bkolko/foneastra/cad/Foneastra v2.3/PCB-4LEDs.jpg

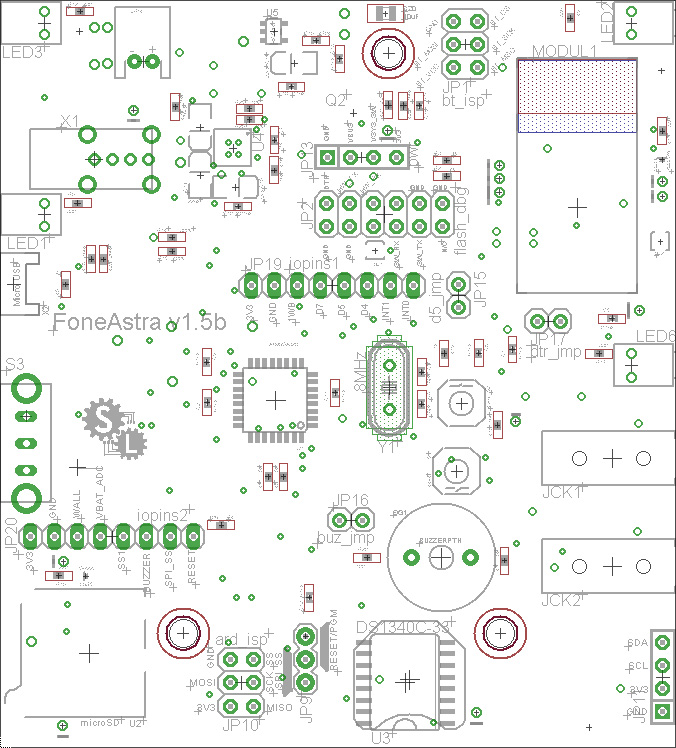
cad/Foneastra v2.3/PCB-4LEDs.jpg
