bkolko/foneastra/bom/FoneAstra Hardware BOM.xlsx

Sheet: Hardware Components
Item | Supplier | Supplier Part # | Manufacturer | Manufacturer Part # | Qty | Notes | Unit Cost | Extended Cost
18-8 Ss Flat Head Phillips Machine Screw, Black Oxide Finish, 6-32 Thread, 3/8" Length | McMaster | 96640A115 |  |  | 8 | Fasten Lid | $0.06 | $0.51
Thread-Forming 18-8SS Screw for Brittle Plastic | McMaster | 97349A210 |  |  | 2 | Set Screw | $0.07 | $0.13
Self-Lock Mushroom-Head Fastener, 1" Wide x 2" Long, Black Rectangle with Super Adhesive Back | McMaster | 87535K63 |  |  | 1 | Velcro | $1.64 | $1.64
Rubber pads | Amazon | 797734857047 |  | AHW071 | 4 | Pads for bottom of case | $0.07 | $0.30
18-8 Stainless Steel, 2-28 Thread, 1/4" Length | McMaster | 99461A715 |  |  | 3 | PCB Screw | $0.22 | $0.67
Weather-Resistant Foam Tape, 1" Width X 5 Yards Length, .063" Thick, Black | McMaster | 76545A92 |  |  | 2in | Adheisve Foam to hold battery | $1.81 | $1.81
Li-ion Battery 1500mAh or greater, 3.7V | SparkFun | PRT-08483 | Unionfortune | 585460 | 1 | Battery | $12.95 | $12.95
Temperature Sensor Probe | SparkFun | SEN-11050 | Dallas Semiconductor | DS18B20 | 1 |  | $9.95 | $9.95
Audio Plug 3.5mm | SparkFun | COM-11143 |  |  | 1 |  | $0.50 | $0.50
1' USB Cables | Amazon | B002L5ZEYY | StarTech | UUSBHAUB1 | 1 |  | $3.99 | $3.99
 |  |  |  |  |  |  |  | $32.45

Sheet: Assembly
Item | Manufacturer/Supplier | Notes | Cost/Unit
PCB | Advanced Circuits |  | $24.14
PCB Assembly | Reliance |  | $85.43
Hardware |  |  | $32.45
Enclosure | ProtoTech |  | $112.75
Labor |  | 60 minutes | $223.75
Total |  |  | $478.53
