bkolko/foneastra/bom/FoneAstra_v1_6_BOM.xlsx

Part | Value | Device | Package | Description | SparkFun | Manufacturer | Manufacturer # | Mouser | Digikey | INCLUDE | Qty | Note
BAT1 | 3V | BATTERY | BATTCON_12MM_CURVED | Battery Holders | http://www.sparkfun.com/products/10592 | MPD (Memory Protection Devices) | BK-885-TR | 534-3000 | BK-885TR-ND |  | 0
C1 | 0.1uF | CAP0402-CAP | 0402-CAP | Capacitor |  | TDK Corporation | C1005X7R1H104K050BB | 810-C1005X7R1H104K | 445-13671-1-ND | x | 1
C10 | 10nF | CAP0402-CAP | 0402-CAP | Capacitor |  | Vishay BC Components | VJ0402Y103KXJCW1BC | 77-VJ0402Y103KXJCBC | BC1217TR-ND | x | 1
C11 | 0.1uF | CAP0402-CAP | 0402-CAP | Capacitor |  | TDK Corporation | C1005X7R1H104K050BB | 810-C1005X7R1H104K | 445-13671-1-ND | x | 1
C12 | 0.1uF | CAP0402-CAP | 0402-CAP | Capacitor |  | TDK Corporation | C1005X7R1H104K050BB | 810-C1005X7R1H104K | 445-13671-1-ND | x | 1
C13 | 0.1uF | CAP0402-CAP | 0402-CAP | Capacitor |  | TDK Corporation | C1005X7R1H104K050BB | 810-C1005X7R1H104K | 445-13671-1-ND | x | 1
C14 | 22uF | CAP_POL1206 | EIA3216 | Capacitor Polarized |  | TDK Corporation | C3216X5R0J226M | 810-C3216X5R0J226M | 445-7717-1-ND | x | 1 | note the part is not really polarized, just the EAGLE footprint
C15 | 22uF | CAP_POL1206 | EIA3216 | Capacitor Polarized |  | TDK Corporation | C3216X5R0J226M | 810-C3216X5R0J226M | 445-7717-1-ND | x | 1 | note the part is not really polarized, just the EAGLE footprint
C16 | 470p | CAP0402-CAP | 0402-CAP | Capacitor |  | Samsung Electro-Mechanics America, Inc | CL05B471KB5NNNC | 581-04025C471K | 1276-1566-1-ND | x | 1
C17 | 22uF | CAP_POL1206 | EIA3216 | Capacitor Polarized |  | TDK Corporation | C3216X5R0J226M | 810-C3216X5R0J226M | 445-7717-1-ND | x | 1
C18 | 0.1uF | CAP0402-CAP | 0402-CAP | Capacitor |  | TDK Corporation | C1005X7R1H104K050BB | 810-C1005X7R1H104K | 445-13671-1-ND | x | 1
C19 | 0.1uF | CAP0402-CAP | 0402-CAP | Capacitor |  | TDK Corporation | C1005X7R1H104K050BB | 810-C1005X7R1H104K | 445-13671-1-ND | x | 1 | model tbd
C20 | 10uf | CAP0805-CAP | 0805-CAP | Capacitor |  | TDK Corporation | C2012X7R0J106K125AB |  | 445-7593-1-ND | x | 1 | extra cap on 3V3. With BT soft start, may not be necessary. Chose 0805 because it's cheaper than 0402.
C21 | 1uF | CAP0402-CAP | 0402-CAP | Capacitor |  | TDK Corporation | C1005X5R1A105K050BB |  | 445-4114-1-ND | x
C2 | 0.1uF | CAP0402-CAP | 0402-CAP | Capacitor |  | TDK Corporation | C1005X7R1H104K050BB | 810-C1005X7R1H104K | 445-13671-1-ND | x | 1
C3 | 18pF | CAP0402-CAP | 0402-CAP | Capacitor |  | TDK Corporation | C1005C0G1H180J050BA | 810-C1005C0G1H180J | 445-1238-1-ND | x | 1
C4 | 18pF | CAP0402-CAP | 0402-CAP | Capacitor |  | TDK Corporation | C1005C0G1H180J050BA | 810-C1005C0G1H180J | 445-1238-1-ND | x | 1
C5 | 0.1uF | CAP0402-CAP | 0402-CAP | Capacitor |  | TDK Corporation | C1005X7R1H104K050BB | 810-C1005X7R1H104K | 445-13671-1-ND | x | 1
C6 | 10uF | CAP_POL1206 | EIA3216 | Capacitor Polarized |  | TDK Corporation | C3216X5R1C106M160AA | 810-C3216X5R1C106M | 445-1426-1-ND | x | 1 | note the part is not really polarized, just the EAGLE footprint
C7 | 10n | CAP0402-CAP | 0402-CAP | Capacitor |  | Vishay BC Components | VJ0402Y103KXJCW1BC | 77-VJ0402Y103KXJCBC | BC1217TR-ND | x | 1
C8 | 0.1uF | CAP0402-CAP | 0402-CAP | Capacitor |  | TDK Corporation | C1005X7R1H104K050BB | 810-C1005X7R1H104K | 445-13671-1-ND | x | 1
C9 | 0.1uF | CAP0402-CAP | 0402-CAP | Capacitor |  | TDK Corporation | C1005X7R1H104K050BB | 810-C1005X7R1H104K | 445-13671-1-ND | x | 1
JCK1 | 35RASMT4BHNTRX | 35RASMT4BHNTRX | 35RASMT4BHNTRX |  |  | Switchcraft Inc. | SC1488-1-ND | 502-35RASMT4BHNTRX | SC1488-1-ND |  | 0
JCK2 | 35RASMT4BHNTRX | 35RASMT4BHNTRX | 35RASMT4BHNTRX |  |  | Switchcraft Inc. | SC1488-1-ND | 502-35RASMT4BHNTRX | SC1488-1-ND | x | 1 | not fitting this part now
JCK3 | 35RASMT4BHNTRX | 35RASMT4BHNTRX | 35RASMT4BHNTRX |  |  | Switchcraft Inc. | SC1488-1-ND | 502-35RASMT4BHNTRX | SC1488-1-ND |  | 0 | not fitting this part not
JP1 | bt_isp | PINHD-2X3 | 2X03 | PIN HEADER | https://www.sparkfun.com/products/12807 | FCI | 67996-206HLF |  | 609-3210-ND | x | 1 | do we meed to install this header in production boards?
JP10 | ard_isp | PINHD-2X3 | 2X03 | PIN HEADER | https://www.sparkfun.com/products/12807 | FCI | 67996-206HLF |  | 609-3210-ND | x | 1 | Can be made from strip(s) of 0.1 breakaway
JP11 | I2C | PINHD-1X4 | 1X04 | PIN HEADER |  | 3M | 961104-6404-AR | 517-9611046404AR |  |  | 0 | Can be made from strip(s) of 0.1 breakaway
JP19 | iopins1 | PINHD-1X8 | 1X08 | PIN HEADER |  | Harwin Inc | M20-9990846 | 649-68418-413HLF | 952-2271-ND |  | 0 | Can be made from strip(s) of 0.1 breakaway
JP20 | iopins2 | PINHD-1X8 | 1X08 | PIN HEADER |  | Harwin Inc | M20-9990846 | 855-M20-9990846 | 952-2271-ND |  | 0 | Can be made from strip(s) of 0.1 breakaway
JP13 | pwr | PINHD-1X4 | 1X04 | PIN HEADER |  | 3M | 961104-6404-AR | 517-9611046404AR |  |  | 0 | Can be made from strip(s) of 0.1 breakaway
JP14 | battconn | M02JST-PTH | JST-2-PTH | 2 pin JST header | https://www.sparkfun.com/products/9749 | JST Sales America Inc | S2B-PH-K-S(LF)(SN) |  | 455-1719-ND | x | 1 | need to doublecheck digikey is same as SF
JP15 | d5_jmp | PINHD-1X2 | 1X02 | PIN HEADER |  | 3M | 961102-6404-AR | 517-9611026404AR |  |  | 0 | Can be made from strip(s) of 0.1 breakaway
JP16 | buz_jmp | PINHD-1X2 | 1X02 | PIN HEADER |  | 3M | 961102-6404-AR | 517-9611026404AR |  |  | 0 | Can be made from strip(s) of 0.1 breakaway
JP17 | dtr_jmp | PINHD-1X2 | 1X02 | PIN HEADER |  | 3M | 961102-6404-AR | 517-9611026404AR |  |  | 0 | Can be made from strip(s) of 0.1 breakaway
JP2 | flash_dbg | PINHD-2X6 | 2X06 | PIN HEADER |  |  |  |  |  |  | 0 | Can be made from strip(s) of 0.1 breakaway
JP3 | SPARKFUN_FIDUCIAL1.5X3 | SPARKFUN_FIDUCIAL1.5X3 | SPARKFUN_FIDUCIAL-1.5X3 | Fiducial Alignment Points |  |  |  |  |  |  | 0 | not a part
JP4 | STAND-OFFTIGHT | STAND-OFFTIGHT | STAND-OFF-TIGHT | #4 Stand Off |  |  |  |  |  |  | 0 | not a part
JP5 | SPARKFUN_FIDUCIAL1.5X3 | SPARKFUN_FIDUCIAL1.5X3 | SPARKFUN_FIDUCIAL-1.5X3 | Fiducial Alignment Points |  |  |  |  |  |  | 0 | not a part | may want to consider enlarging this to 2x8 to find more parts
JP6 | STAND-OFFTIGHT | STAND-OFFTIGHT | STAND-OFF-TIGHT | #4 Stand Off |  |  |  |  |  |  | 0 | not a part
JP7 | SPARKFUN_FIDUCIAL1.5X3 | SPARKFUN_FIDUCIAL1.5X3 | SPARKFUN_FIDUCIAL-1.5X3 | Fiducial Alignment Points |  |  |  |  |  |  | 0 | not a part
JP8 | STAND-OFFTIGHT | STAND-OFFTIGHT | STAND-OFF-TIGHT | #4 Stand Off |  |  |  |  |  |  | 0 | not a part
JP9 | spi_jmp | M03PTH | 1X03 | Header 3 |  | 3M | 961103-6804-AR | 517-9611036804AR | 961103-6804-AR-ND | x | 1 | Can be made from strip(s) of 0.1 breakaway
LED1 | RED | LED | LXH4 | LEDs |  | Lumex Opto/Components Inc | SSF-LXH4RAID |  | 67-1303-ND | x | 1
LED2 | YELLOW | LED | LXH4 | LEDs |  | Lumex Opto/Components Inc | SSF-LXH4RAYD |  | 67-1305-ND | x | 1 | Note: LXH series has no blue. This is green. There is only red, green, yellow in this exact body
LED3 | RED | LED | LXH4 | LEDs |  | Lumex Opto/Components Inc | SSF-LXH4RAID |  | 67-1303-ND | x | 1
LED4 | YELLOW | LED0603 | LED-0603 | LEDs |  | Vishay Semiconductor Opto Division | TLMY1100-GS08 | 720-LYQ976-P1S2-36 | 751-1186-1-ND | x | 1
LED5 | Green | LED0603 | LED-0603 | LEDs |  | Stanley Electric Co | PG1111C-TR | 720-LGQ971-KN-1 | 404-1004-1-ND | x | 1
LED6 | RED | LED | LXH4 | LEDs |  | Lumex Opto/Components Inc | SSF-LXH4RAID |  | 67-1303-ND | x | 1 | Note: LXH series has no blue. This is green. There is only red, green, yellow in this exact body
Y1 | 8MHz | CRYSTALHC49S | HC49/S | CRYSTAL |  | CTS-Frequency Controls | ATS080B | 695-HC49US-8-U | CTX900-ND | x | 1
Q2 | FDN306P | FDN306P | MYSOT23 |  |  | Fairchild Semiconductor | FDN306P | 512-FDN306P | FDN306PCT-ND | x | 1
R1 | 5k | RESISTOR0402-RES | 0402-RES | Resistor |  | Panasonic Electronic Components | ERJ-2GEJ512X |  | P5.1KJCT-ND | x | 1 | note: none of these resistor tolerances are very important, go with cheapest
R10 | 10k | RESISTOR0402-RES | 0402-RES | Resistor |  | Vishay Dale | CRCW040210K0FKED | 71-CRCW0402-10K-E3 | 541-10.0KLCT-ND | x | 1
R11 | 330 | RESISTOR0402-RES | 0402-RES | Resistor |  | Panasonic Electronic Components | ERJ-2GEJ331X | ERJ-2GEJ331X | P330JCT-ND | x | 1
R12 | 100 | RESISTOR0402-RES | 0402-RES | Resistor |  | Panasonic Electronic Components | ERJ-2GEJ101X | ERJ-2GEJ101X | P100JCT-ND | x | 1
R13 | 10K | RESISTOR0402-RES | 0402-RES | Resistor |  | Vishay Dale | CRCW040210K0FKED |  | 541-10.0KLCT-ND | x | 1
R14 | 300k | RESISTOR0402-RES | 0402-RES | Resistor |  | Panasonic Electronic Components | ERJ-2GEJ304X |  | P300KJCT-ND | x | 1
R15 | 100k | RESISTOR0402-RES | 0402-RES | Resistor |  | Vishay Dale | CRCW0402100KFKED |  | 541-10.0KLCT-ND | x | 1
R16 | 220 | RESISTOR0402-RES | 0402-RES | Resistor |  | Panasonic Electronic Components | ERJ-2RKF2200X |  | P220LCT-ND | x | 1
R17 | 100 | RESISTOR0402-RES | 0402-RES | Resistor |  | Panasonic Electronic Components | ERJ-2GEJ101X | ERJ-2GEJ101X | P100JCT-ND | x | 1
R18 | 100k | RESISTOR0402-RES | 0402-RES | Resistor |  | Vishay Dale | CRCW0402100KFKED |  | 541-10.0KLCT-ND | x | 1
R19 | 1k | RESISTOR0402-RES | 0402-RES | Resistor |  | Panasonic Electronic Components | ERJ-2GEJ102X |  | 541-10.0KLCT-ND | x | 1
R2 | 1k | RESISTOR0402-RES | 0402-RES | Resistor |  | Panasonic Electronic Components | ERJ-2GEJ102X |  | P1.0KJCT-ND | x | 1
R20 | 100 | RESISTOR0402-RES | 0402-RES | Resistor |  | Panasonic Electronic Components | ERJ-2GEJ101X |  | P100JCT-ND | x | 1
R21 | 100k | RESISTOR0402-RES | 0402-RES | Resistor |  | Vishay Dale | CRCW0402100KFKED |  | 541-10.0KLCT-ND | x | 1
R22 | 2.2M | RESISTOR0402-RES | 0402-RES | Resistor |  | Vishay Dale | CRCW04022M20JNED |  | 541-2.2MJCT-ND | x | 1
R23 | 200k | RESISTOR0402-RES | 0402-RES | Resistor |  | Vishay Dale | CRCW0402200KJNED |  | 541-200KJCT-ND | x | 1
R24 | 10k | RESISTOR0402-RES | 0402-RES | Resistor |  | Vishay Dale | CRCW040210K0FKED |  | 541-10.0KLCT-ND | x | 1
R25 | 10k | RESISTOR0402-RES | 0402-RES | Resistor |  | Vishay Dale | CRCW040210K0FKED |  | 541-10.0KLCT-ND | x | 1
R26 | 10k | RESISTOR0402-RES | 0402-RES | Resistor |  | Vishay Dale | CRCW040210K0FKED |  | 541-10.0KLCT-ND | x | 1
R3 | 1k | RESISTOR0402-RES | 0402-RES | Resistor |  | Panasonic Electronic Components | ERJ-2GEJ102X |  | 541-10.0KLCT-ND | x | 1
R4 | 10K | RESISTOR0402-RES | 0402-RES | Resistor |  | Panasonic Electronic Components | ERJ-2GEJ103X |  | P10KJCT-ND | x | 1
R5 | 0 | RESISTOR0402-RES | 0402-RES | Resistor |  | Vishay Dale | CRCW04020000Z0ED | 71-CRCW0402-0-E3 | 541-0.0JCT-ND |  | 0 | do not fit unless we decide we need it later to incrase charge current
R6 | 100 | RESISTOR0402-RES | 0402-RES | Resistor |  | Panasonic Electronic Components | ERJ-2GEJ101X |  | P100JCT-ND | x | 1
R7 | 5k | RESISTOR0402-RES | 0402-RES | Resistor |  | Vishay Dale | CRCW04024K70JNED | 71-CRCW0402J-4.7K-E3 | 541-4.7KJCT-ND | x | 1
R8 | 5k | RESISTOR0402-RES | 0402-RES | Resistor |  | Vishay Dale | CRCW04024K70JNED | 71-CRCW0402J-4.7K-E3 | 541-4.7KJCT-ND | x | 1 | note: I swapped out these 5k resistors for 4.7k resistors. Should not make a difference, and these are more common and cheaper
R9 | 100 | RESISTOR0402-RES | 0402-RES | Resistor |  | Panasonic Electronic Components | ERJ-2GEJ101X | ERJ-2GEJ101X | P100JCT-ND | x | 1
S1 | Reset | TAC_SWITCHSMD | TACTILE_SWITCH_SMD | Momentary Switch |  | C&K Components | PTS525SM10SMTR LFS | 611-PTS525SM10-LFS | CKN9104CT-ND | x | 1 | note: orig digikey part number EG1831-ND seems wrong for this switch; I updated it to what I think matches the footprint
S3 | E-SWITCH-EG1206 | E-SWITCH-EG1206 | EG1206 |  |  | E-Switch | EG1206 | 612-EG1206 | EG1916-ND | x | 1
S2 | intsw | SPARKFUN_TAC_SWITCHSMD | SPARKFUN_TACTILE_SWITCH_SMD | Momentary Switch |  | C&K Components | PTS525SM10SMTR LFS | 611-PTS525SM10-LFS | CKN9104CT-ND | x | 1 | note: orig digikey part number EG1831-ND seems wrong for this switch; I updated it to what I think matches the footprint
SG1 | BUZZERPTH | BUZZERPTH | BUZZER-12MM | Buzzer 12mm | https://www.sparkfun.com/products/7950 | CUI Inc | CEM-1203(42) | 254-EMB140-RO | 102-1153-ND |  | 0
SJ1 |  | SOLDERJUMPERNC2 | SJ_2S-NOTRACE | Solder Jumper |  |  |  |  |  |  | 0 | not a part
SJ2 |  | SOLDERJUMPERNC2 | SJ_2S-NOTRACE | Solder Jumper |  |  |  |  |  |  | 0 | not a part
TP3 | SS | TESTPOINT | TESTPOINT |  |  |  |  |  |  |  | 0 | not a part
TP1 | BT_RESET | TESTPOINT | TESTPOINT |  |  |  |  |  |  |  | 0 | not a part
TP10 | PIO4 | TESTPOINT | TESTPOINT |  |  |  |  |  |  |  | 0 | not a part
TP11 | BT_PWR | TESTPOINT | TESTPOINT |  |  |  |  |  |  |  | 0 | not a part
TP12 | BT_VCC | TESTPOINT | TESTPOINT |  |  |  |  |  |  |  | 0 | not a part
TP2 | FT/OUT | TESTPOINT | TESTPOINT |  |  |  |  |  |  |  | 0 | not a part
TP4 | PIO3 | TESTPOINT | TESTPOINT |  |  |  |  |  |  |  | 0 | not a part
TP5 | PIO7 | TESTPOINT | TESTPOINT |  |  |  |  |  |  |  | 0 | not a part
TP6 | PIO6 | TESTPOINT | TESTPOINT |  |  |  |  |  |  |  | 0 | not a part
TP7 | PIO5 | TESTPOINT | TESTPOINT |  |  |  |  |  |  |  | 0 | not a part
TP8 | GND | TESTPOINT | TESTPOINT |  |  |  |  |  |  |  | 0 | not a part
TP9 | GND | TESTPOINT | TESTPOINT |  |  |  |  |  |  |  | 0 | not a part
U1 | ATMEGA328 | ATMEGA168 | TQFP32-08 |  |  | Atmel | ATMEGA328P-AU | 556-ATMEGA328P-AU | ATMEGA328P-AU-ND | x | 1
U2 | microSD | USD-SOCKETSMD | MICRO-SD-SOCKET-PP | microSD Socket | SFE: https://www.sparkfun.com/products/127 | 3M | 2908-05WB-MG |  | 3M5607CT-ND | x | 1 | need to double check -- SFE part does not give manufacturer number. 3M part seems to be the right one, but..
MODUL1 | BLUETOOTH-RN42 | BLUETOOTH-RN41","RN41 |  |  | SFE: https://www.sparkfun.com/products/10253 | Microchip Technology | RN42-I/RM |  | 740-1038-ND | x | 1 | need to double check -- there are several RN-42s, slightly different
U3 | DS1340C-33 | DS1340C-33 | SO16L |  |  | Maxim Integrated | DS1340C-33#T&R |  | DS1340C-33#-ND |  | 0
U4 | ADP5062 | ADP5062 | LFCSP_WQ20 |  |  | Analog Devices Inc | ADP5062ACPZ-2-R7 | 584-ADP5062ACPZ-1-R7 | ADP5062ACPZ-2-R7CT-ND | x | 1
U5 | MIC5245 | V_REG_LDOSMD | SOT23-5 | Voltage Regulator LDO |  | Micrel Inc | MIC5245-3.3YM5 |  | 576-2790-1-ND | x | 1
X1 | MOLEX48204_USB_A_VERT | MOLEX48204_USB_A_VERT |  | USB Connectors | 538-48204-0001 | Molex Inc | 482040001 | WM17532-ND | WM17532-ND | x | 1
X2 | Micro USB | USB-MICROB | USB-MICROB | USB Connectors |  | FCI | 10104111-0001LF |  | 609-4053-1-ND | x | 1
