bkolko/foneastra/cad/Foneastra v2.3/phonejack-35RASMT.SLDPRT

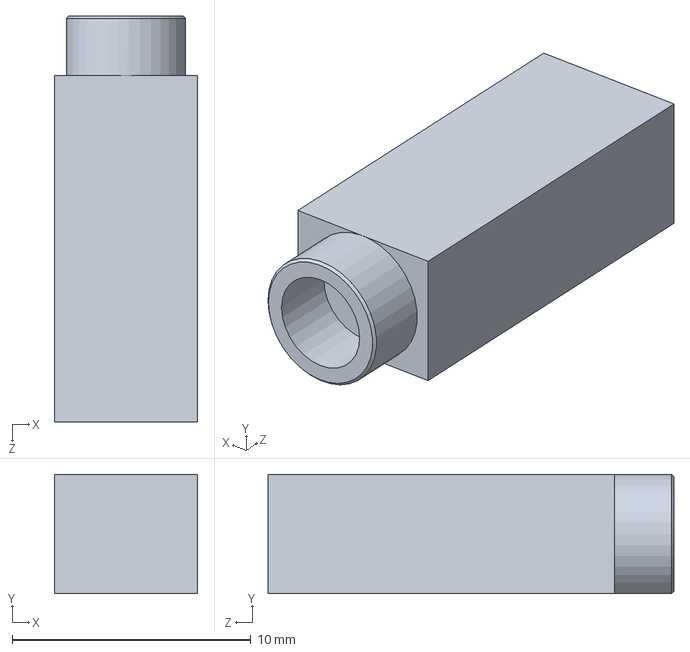
[picture p4: CAD file, 2015-06-15]
cad/Foneastra v2.3/phonejack-35RASMT.SLDPRT
6.00 x 5.00 x 17.0 mm
