bkolko/foneastra/cad/Foneastra v2.3/FoneAstra_PCB1-5.SLDASM

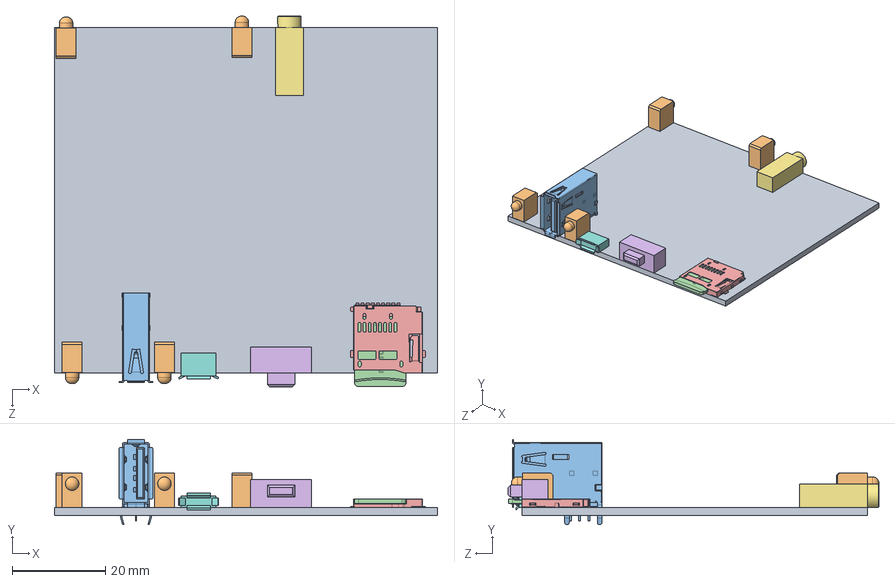
[picture p5: CAD file, 2015-06-15]
cad/Foneastra v2.3/FoneAstra_PCB1-5.SLDASM
82.0 x 18.3 x 79.4 mm
PCB
LED_3mm_591-2601-013F x 4
sd
slot
Switch-EG1916
phonejack-35RASMT
microUSB-10104
