bkolko/foneastra/cad/Foneastra v2.3/Foneastra_v2-3_Assembled.SLDASM

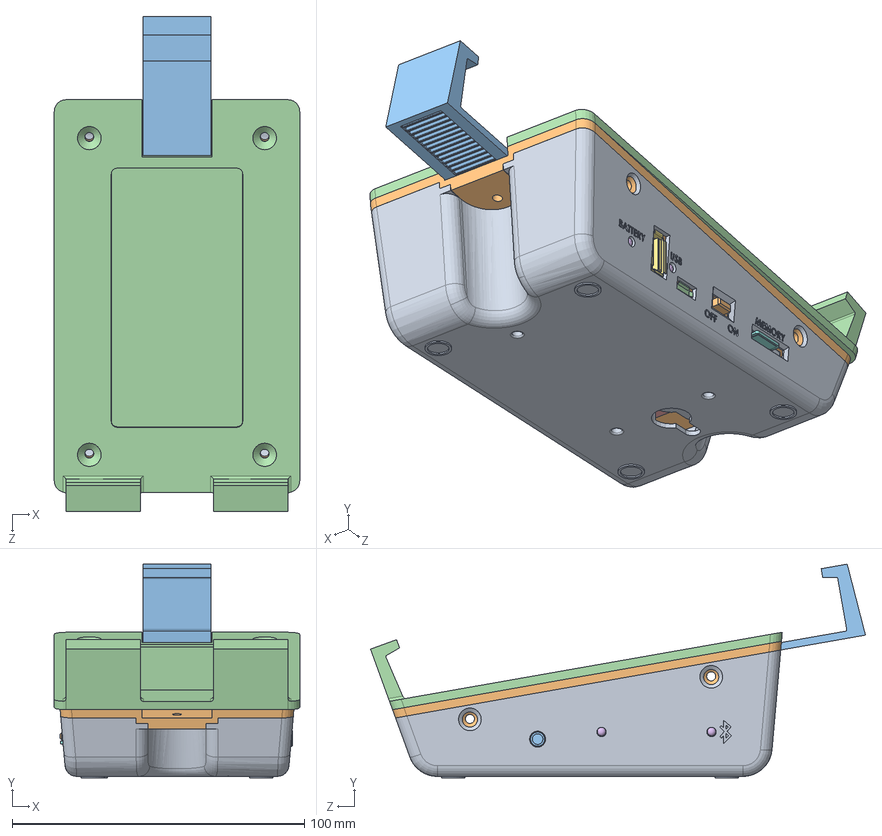
[picture p6: CAD file, 2015-06-15]
cad/Foneastra v2.3/Foneastra_v2-3_Assembled.SLDASM
84.0 x 73.1 x 169.3 mm
Lid
Slider
Sled
PCB
LED_3mm_591-2601-013F x 4
sd
slot
Switch-EG1916
phonejack-35RASMT
microUSB-10104
