bkolko/foneastra/cad/Foneastra v2.3/SD-card.SLDASM

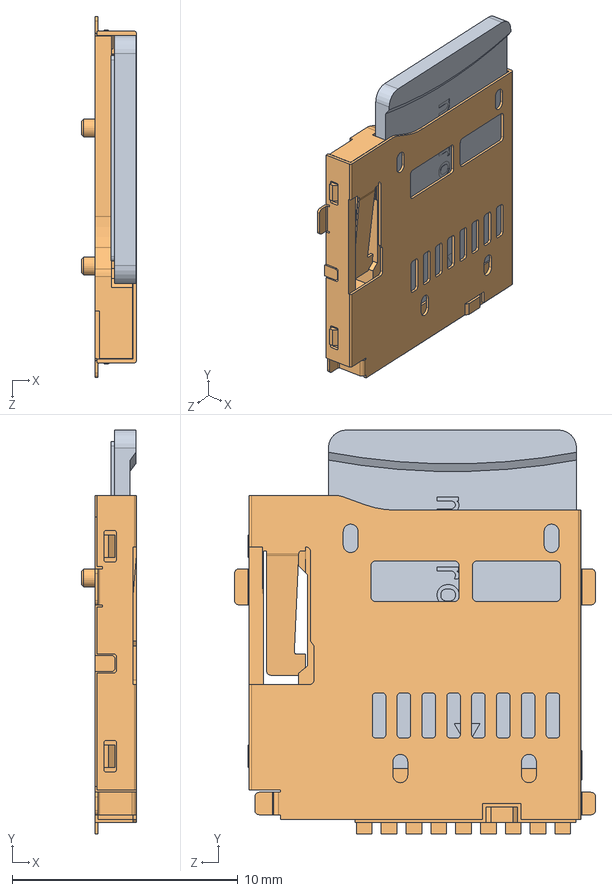
[picture p7: CAD file, 2015-06-15]
cad/Foneastra v2.3/SD-card.SLDASM
2.44 x 17.9 x 16.0 mm
sd
slot
