bkolko/foneastra/cad/Foneastra v2.3/LED_3mm_591-2601-013F.sldprt

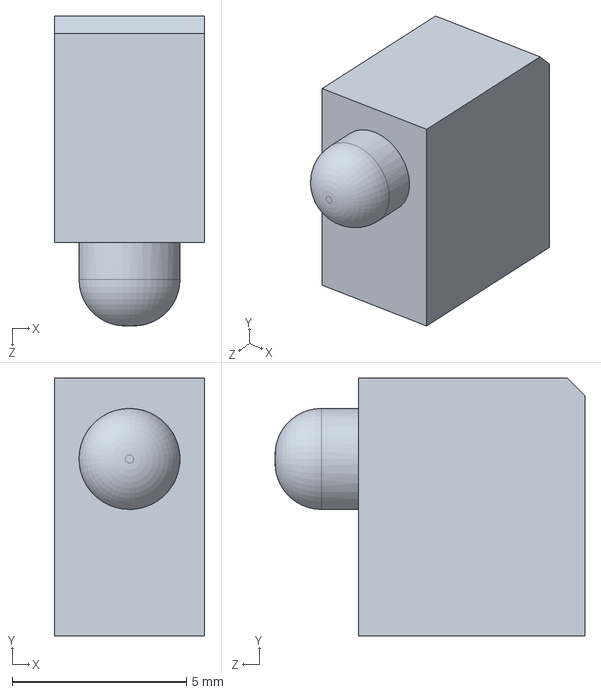
[picture p8: CAD file, 2015-06-15]
cad/Foneastra v2.3/LED_3mm_591-2601-013F.sldprt
4.32 x 7.40 x 8.90 mm
