bkolko/foneastra/cad/Foneastra v2.3/Sled.sldprt

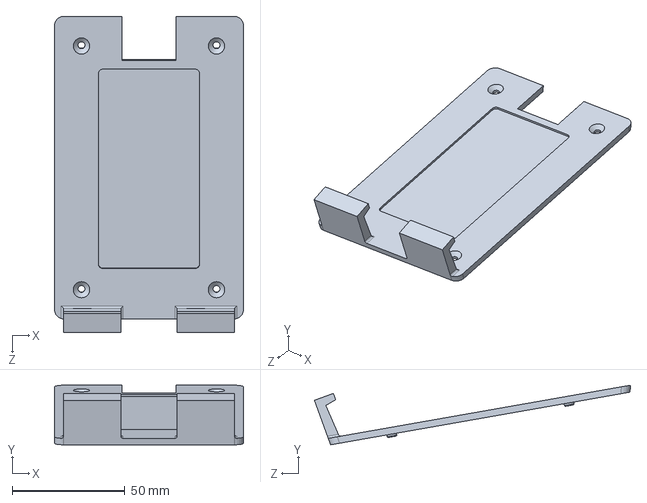
[picture p9: CAD file, 2015-06-15]
cad/Foneastra v2.3/Sled.sldprt
84.0 x 26.5 x 140.5 mm
