bkolko/foneastra/cad/Foneastra v2.3/Slider.sldprt

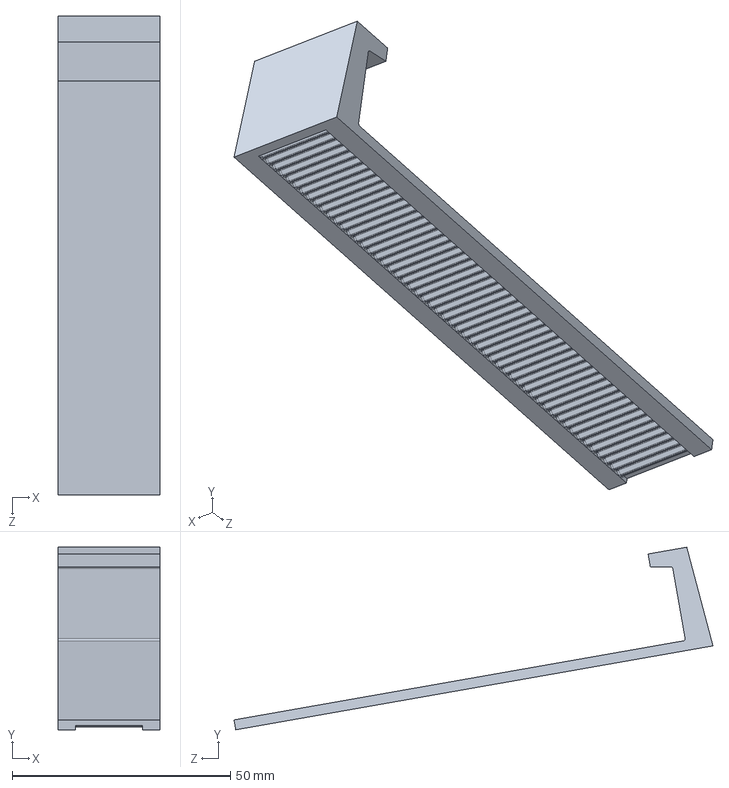
[picture p10: CAD file, 2015-06-15]
cad/Foneastra v2.3/Slider.sldprt
23.4 x 41.8 x 109.7 mm
