bkolko/foneastra/cad/Foneastra v2.3/Body.sldprt

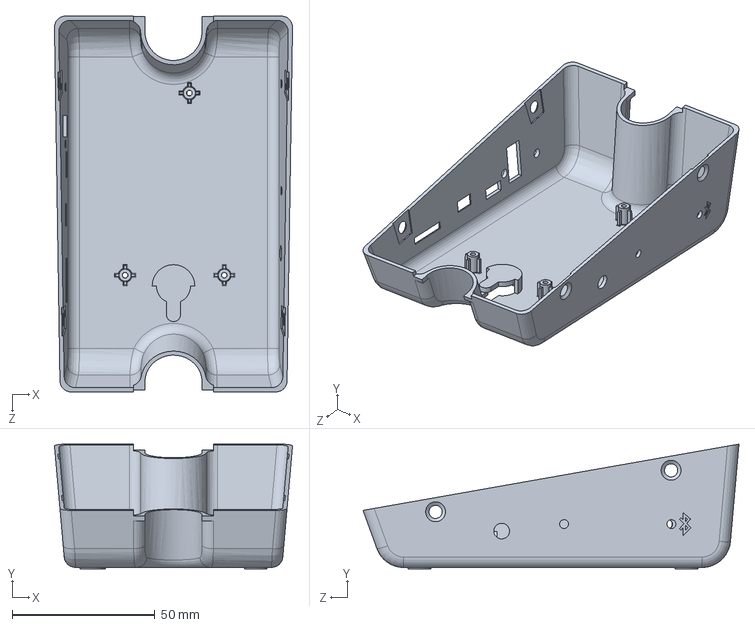
[picture p11: CAD file, 2015-06-15]
cad/Foneastra v2.3/Body.sldprt
83.4 x 43.7 x 131.8 mm
