bkolko/foneastra/cad/Foneastra v2.3/microUSB-10104.SLDPRT

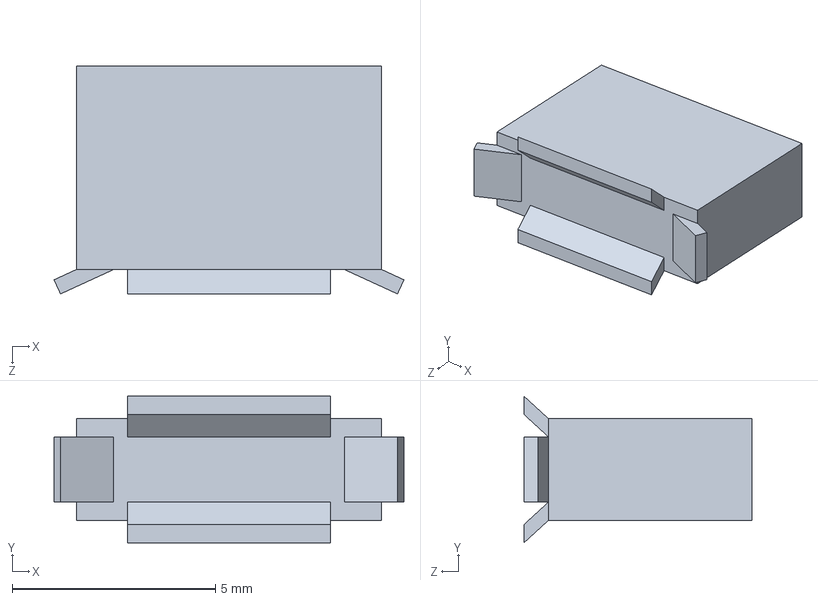
[picture p12: CAD file, 2015-06-15]
cad/Foneastra v2.3/microUSB-10104.SLDPRT
8.60 x 3.60 x 5.60 mm
