bkolko/foneastra/cad/Foneastra v2.3/Switch-EG1916.SLDPRT

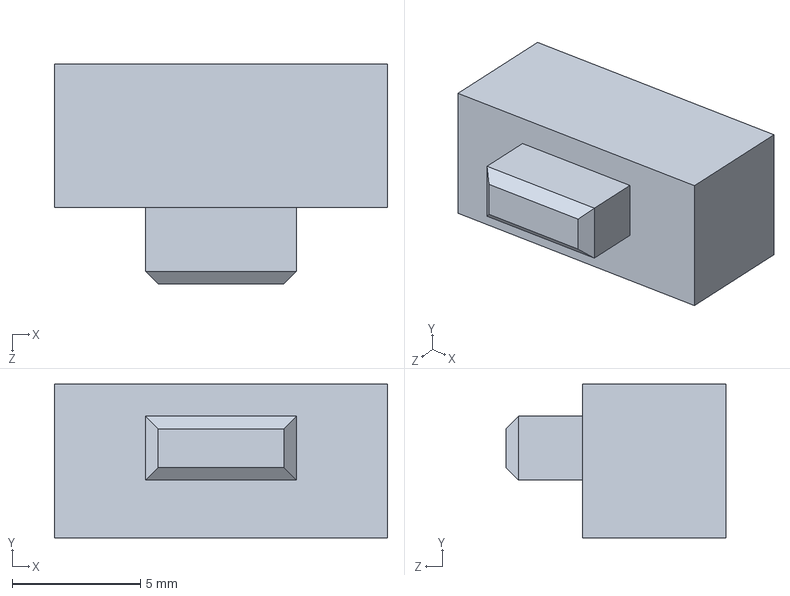
[picture p13: CAD file, 2015-06-15]
cad/Foneastra v2.3/Switch-EG1916.SLDPRT
13.0 x 6.00 x 8.60 mm
