bkolko/foneastra/cad/Foneastra v2.3/Lid.sldprt

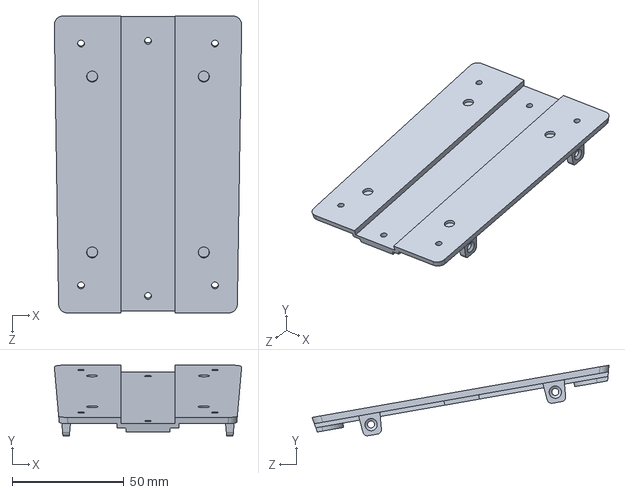
[picture p14: CAD file, 2015-06-15]
cad/Foneastra v2.3/Lid.sldprt
84.0 x 31.6 x 133.1 mm
