bkolko/foneastra/cad/Foneastra v2.3/PCB.sldprt

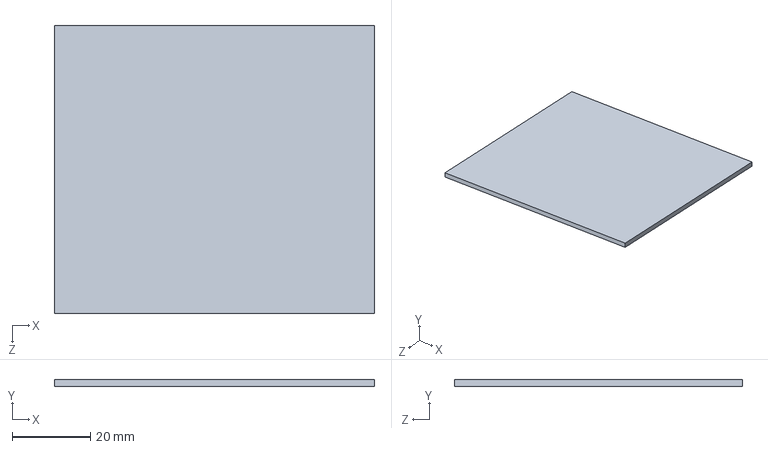
[picture p15: CAD file, 2015-06-15]
cad/Foneastra v2.3/PCB.sldprt
82.0 x 1.75 x 73.9 mm
