bkolko/foneastra/cad/Foneastra v2.3/48204-0001.SLDPRT

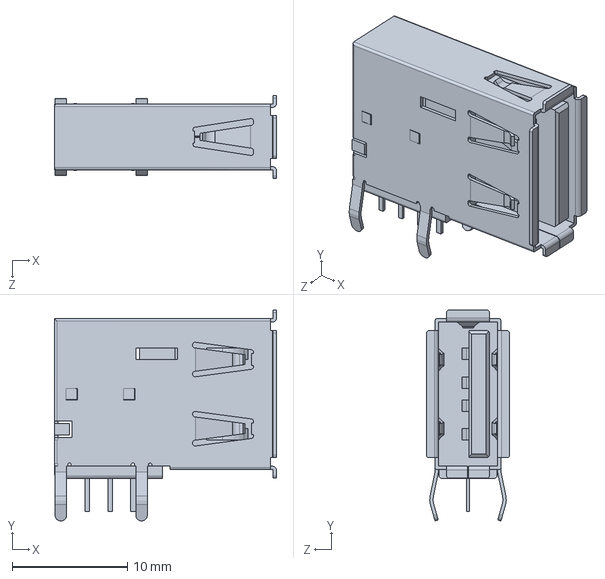
[picture p16: CAD file, 2015-06-15]
cad/Foneastra v2.3/48204-0001.SLDPRT
19.2 x 18.3 x 7.20 mm
