bkolko/foneastra/(list of files, cad)

Other CAD files:
cad/Foneastra v2.3/P1.sldasm
cad/Foneastra v2.3/slot.sldasm
cad/Foneastra v2.3/sd.sldasm
cad/Foneastra v2.3/STLs/Body.STL
cad/Foneastra v2.3/STLs/Lid.STL
cad/Foneastra v2.3/STLs/Sled.STL
cad/Foneastra v2.3/sd.sldprt
cad/Foneastra v2.3/slot.sldprt
