bkolko/foneastra/pcb/FoneAstra.brd

## EAGLE design pcb/FoneAstra.brd (2015-03-05)

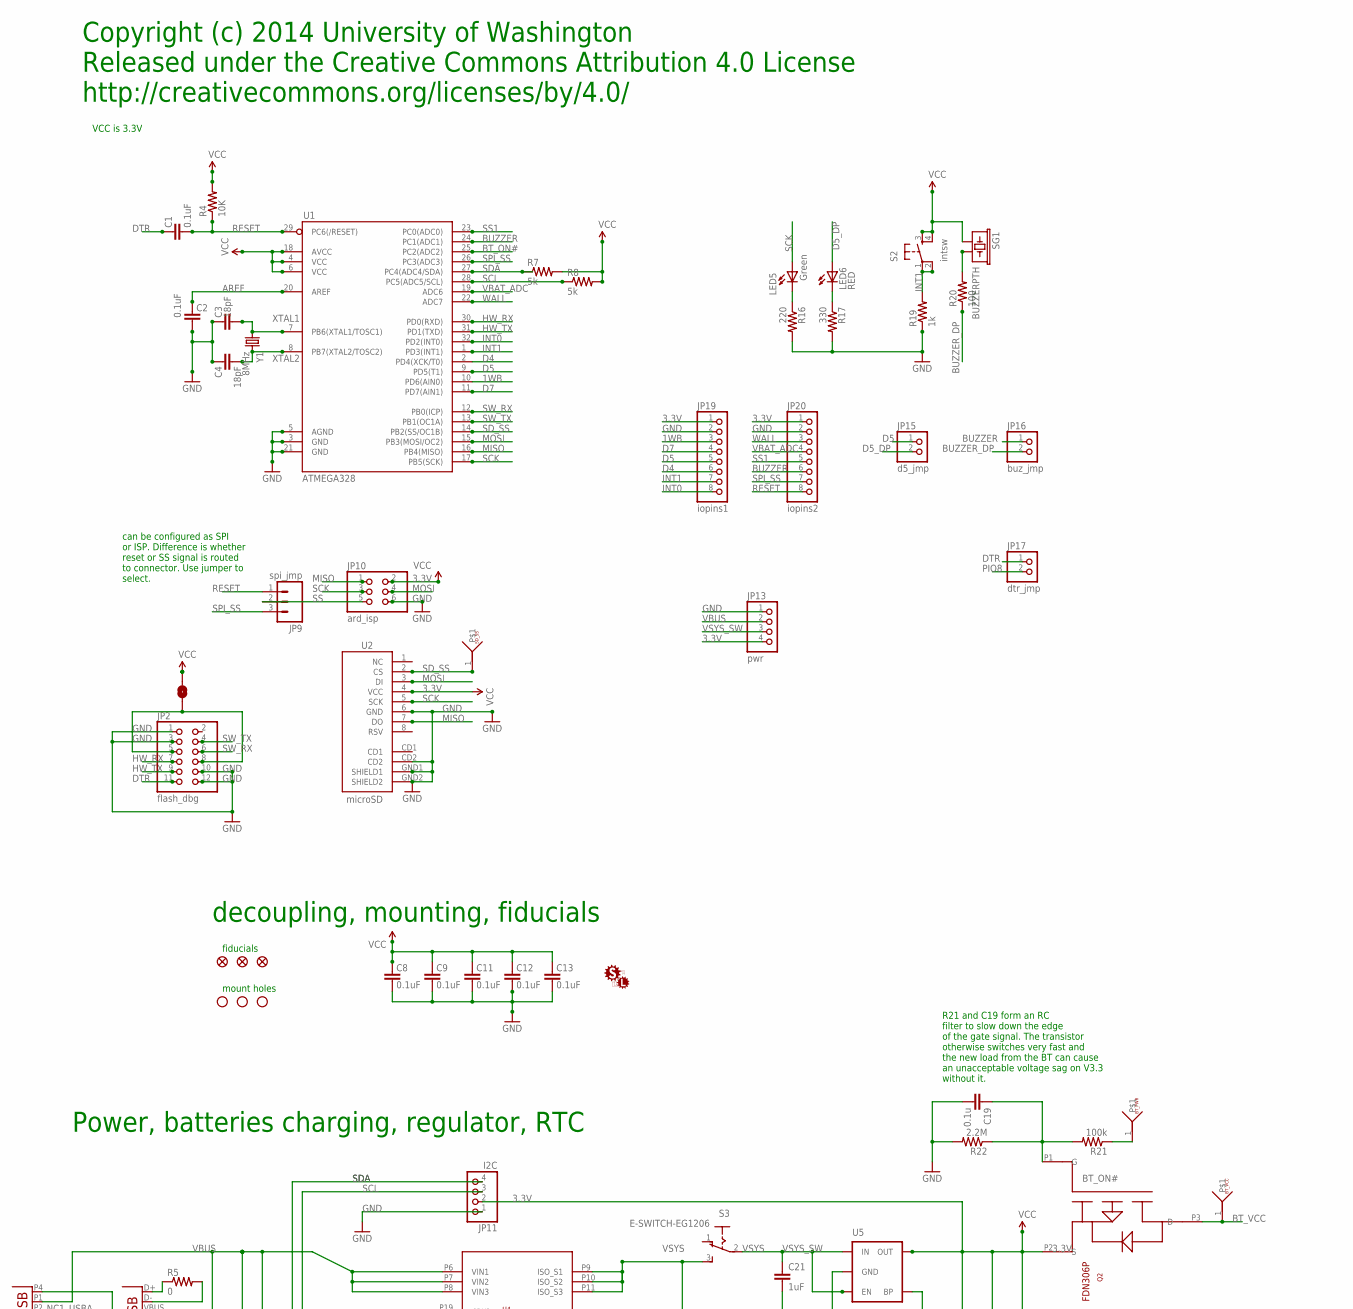
[picture p17: schematic FoneAstra.sch, part in row 1, column 1]

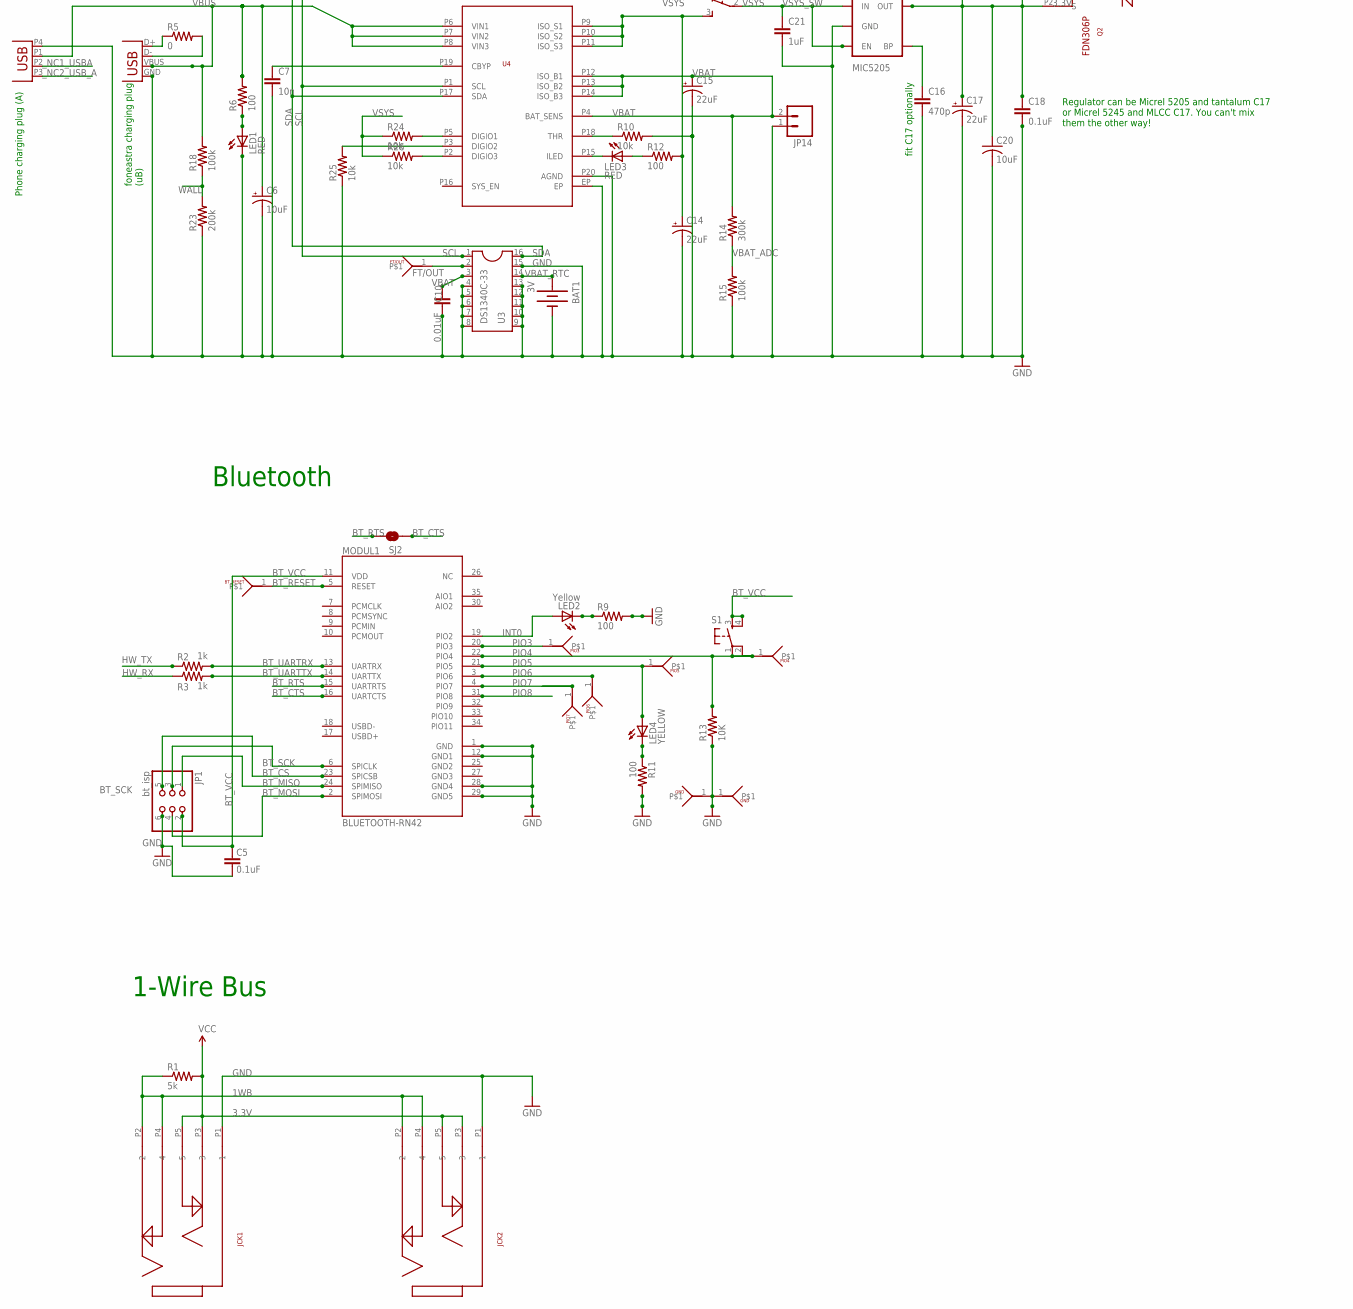
[picture p18: schematic FoneAstra.sch, part in row 2, column 1]

Parts:
BAT1: 3V; BATTCON_12MM_CURVED
C1, C2, C5, C8, C9, C11, C12, C13, C18: 0.1uF; 0402-CAP
C3, C4: 18pF; 0402-CAP
C6: 10uF; EIA3216
C7: 10n; 0402-CAP
C10: 0.01uF; 0402-CAP
C14, C15, C17: 22uF; EIA3216
C16: 470p; 0402-CAP
C19: 0.1u; 0402-CAP
C20: 10uF; C0805
C21: 1uF; 0402-CAP
JCK1, JCK2: 35RASMT4BHNTRX
JP1: bt_isp; 2X03
JP2: flash_dbg; 2X06
JP3, JP5, JP7: SPARKFUN_FIDUCIAL1.5X3; SPARKFUN_FIDUCIAL-1.5X3
JP4, JP6, JP8: STAND-OFFTIGHT; STAND-OFF-TIGHT
JP9: spi_jmp; 1X03
JP10: ard_isp; 2X03
JP11: I2C; 1X04
JP13: pwr; 1X04
JP14: SPARKFUN_M02JST-PTH-2; SPARKFUN_JST-2-PTH
JP15: d5_jmp; 1X02
JP16: buz_jmp; 1X02
JP17: dtr_jmp; 1X02
JP19: iopins1; 1X08
JP20: iopins2; 1X08
LED1, LED3, LED6: RED; LXH4
LED2: Yellow; LXH4
LED4: YELLOW; LED-0603
LED5: Green; LED-0603
MODUL1: BLUETOOTH-RN42; SPARKFUN_RN41
Q2: FDN306P; MYSOT23
R1, R7, R8: 5k; 0402-RES
R2, R3, R19: 1k; 0402-RES
R4, R13: 10K; 0402-RES
R5: 0; 0402-RES
R6, R9, R11, R12, R20: 100; 0402-RES
R10, R24, R25, R26: 10k; 0402-RES
R14: 300k; 0402-RES
R15, R18, R21: 100k; 0402-RES
R16: 220; 0402-RES
R17: 330; 0402-RES
R22: 2.2M; 0402-RES
R23: 200k; 0402-RES
S1: Reset; TACTILE_SWITCH_SMD
S2: intsw; SPARKFUN_TACTILE_SWITCH_SMD
S3: E-SWITCH-EG1206; EG1206
SG1: BUZZERPTH; BUZZER-12MM
SJ1, SJ2: SOLDERJUMPERNC2; SJ_2S-NOTRACE
TP1: BT_RESET; TESTPOINT
TP2: FT/OUT; TESTPOINT
TP3: SD_SS; TESTPOINT
TP4: PIO3; TESTPOINT
TP5: PIO7; TESTPOINT
TP6: PIO6; TESTPOINT
TP7: PIO5; TESTPOINT
TP8, TP9: GND; TESTPOINT
TP10: PIO4; TESTPOINT
TP11: BT_PWR; TESTPOINT
TP12: BT_VCC; TESTPOINT
U1: ATMEGA328; TQFP32-08
U2: microSD; SPARKFUN_MICRO-SD-SOCKET-PP
U3: DS1340C-33; SO16L
U4: ADP5062; LFCSP_WQ20
U5: MIC5205; SOT23-5
U$2: SHIFT_LOGO
X1: MOLEX48204_USB_A_VERT
X2: Micro USB; USB-MICROB
Y1: 8MHz; HC49/S

Connections:
1WB: JCK1.P2 (2), JCK1.P4 (4), JCK2.P2 (2), JCK2.P4 (4), JP19.3, R1.1, U1.10 (PD6(AIN0))
3.3V: C8.2, C9.2, C11.2, C12.2, C13.2, C17.A (+), C18.1, C20.1, JCK1.P3 (3), JCK1.P5 (5), JCK2.P3 (3), JCK2.P5 (5), JP10.2, JP11.2, JP13.4, JP19.1, JP20.1, Q2.P2 (S), R1.2, R4.2, R7.2, R8.2, S2.3, S2.4, SG1.+ (1), SJ1.1, U1.4 (VCC), U1.6 (VCC), U1.18 (AVCC), U2.4 (VCC), U5.5 (OUT)
AREF: C2.2, U1.20 (AREF)
BT_CS: JP1.5, MODUL1.23 (SPICSB)
BT_CTS: MODUL1.16 (UARTCTS), SJ2.1
BT_MISO: JP1.1, MODUL1.24 (SPIMISO)
BT_MOSI: JP1.4, MODUL1.2 (SPIMOSI)
BT_ON#: R21.1, TP11.1, U1.25 (PC2(ADC2))
BT_ON_G: C19.1, Q2.P1 (G), R21.2, R22.1
BT_RESET: MODUL1.5 (RESET), TP1.1
BT_RTS: MODUL1.15 (UARTRTS), SJ2.2
BT_SCK: JP1.3, MODUL1.6 (SPICLK)
BT_UARTRX: MODUL1.13 (UARTRX), R2.2
BT_UARTTX: MODUL1.14 (UARTTX), R3.2
BT_VCC: C5.2, JP1.2, MODUL1.11 (VDD), Q2.P3 (D), S1.3, S1.4, TP12.1
BUZZER: JP16.1, JP20.6, U1.24 (PC1(ADC1))
BUZZER_DP: JP16.2, R20.1
CHG_L_2: LED3.K (C), U4.P15 (ILED)
CHG_THR: R10.1, U4.P18 (THR)
CH_L1: LED3.A, R12.1
D1: LED4.C, R11.1
D4: JP19.6, U1.2 (PD4(XCK/T0))
D5: JP15.1, JP19.5, U1.9 (PD5(T1))
D5_DP: JP15.2, LED6.A
D7: JP19.4, U1.11 (PD7(AIN1))
DTR: C1.2, JP2.11, JP17.1
FT/OUT: TP2.1, U3.2
GND: BAT1.GND (-), C2.1, C3.2, C4.2, C5.1, C6.C (-), C7.2, C8.1, C9.1, C10.1, C11.1, C12.1, C13.1, C14.C (-), C15.C (-), C16.2, C17.C (-), C18.2, C19.2, C20.2, C21.2, JCK1.P1 (1), JCK2.P1 (1), JP1.6, JP2.1, JP2.3, JP2.10, JP2.12, JP10.6, JP11.1, JP13.1, JP14.1, JP19.2, JP20.2, LED1.K (C), MODUL1.1 (GND), MODUL1.12 (GND1), MODUL1.28 (GND4), MODUL1.29 (GND5), R9.2, R10.2, R11.2, R13.1, R15.1, R16.2, R17.2, R19.1, R22.2, R23.1, R25.1, TP8.1, TP9.1, U1.3 (GND), U1.5 (AGND), U1.21 (GND), U2.6 (GND), U2.CD2, U2.GND1 (SHIELD1), U2.GND2 (SHIELD2), U3.4, U3.5, U3.6, U3.7, U3.8, U3.9, U3.10, U3.11, U3.12, U3.13, U3.15, U4.EP, U4.P20 (AGND), U5.2 (GND), X1.P4 (GND), X2.GND
HW_RX: JP2.7, R3.1, U1.30 (PD0(RXD))
HW_TX: JP2.9, R2.1, U1.31 (PD1(TXD))
INT0: JP19.8, LED2.A, MODUL1.19 (PIO2), U1.32 (PD2(INT0))
INT1: JP19.7, R19.2, S2.1, S2.2, U1.1 (PD3(INT1))
MISO: JP10.1, U1.16 (PB4(MISO)), U2.7 (DO)
MOSI: JP10.4, U1.15 (PB3(MOSI/OC2)), U2.3 (DI)
unnamed: R20.2, SG1.- (2)
unnamed: JP2.5, JP2.8, SJ1.2
unnamed: C7.1, U4.P19 (CBYP)
unnamed: R24.2, U4.P5 (DIGIO1)
unnamed: LED6.K (C), R17.1
unnamed: R26.2, U4.P2 (DIGIO3)
unnamed: LED5.C, R16.1
unnamed: LED2.K (C), R9.1
unnamed: LED1.A, R6.1
unnamed: C16.1, U5.4 (BP)
unnamed: R25.2, U4.P3 (DIGIO2)
unnamed: R5.2, X2.D-
unnamed: R5.1, X2.D+
PIO3: MODUL1.20 (PIO3), TP4.1
PIO4: MODUL1.22 (PIO4), R13.2, S1.1, S1.2, TP10.1
PIO5: LED4.A, MODUL1.21 (PIO5), TP7.1
PIO6: MODUL1.3 (PIO6), TP6.1
PIO7: MODUL1.4 (PIO7), TP5.1
PIO8: JP17.2, MODUL1.31 (PIO8)
RESET: C1.1, JP9.1, JP20.8, R4.1, U1.29 (PC6(/RESET))
SCK: JP10.3, LED5.A, U1.17 (PB5(SCK)), U2.5 (SCK)
SCL: JP11.3, R8.1, U1.28 (PC5(ADC5/SCL)), U3.1, U4.P1 (SCL)
SDA: JP11.4, R7.1, U1.27 (PC4(ADC4/SDA)), U3.16, U4.P17 (SDA)
SD_SS: TP3.1, U1.14 (PB2(SS/OC1B)), U2.2 (CS)
SPI_SS: JP9.3, JP20.7, U1.26 (PC3(ADC3))
SS: JP9.2, JP10.5
SS1: JP20.5, U1.23 (PC0(ADC0))
SW_RX: JP2.6, U1.12 (PB0(ICP))
SW_TX: JP2.4, U1.13 (PB1(OC1A))
VBAT: C10.2, C15.A (+), JP14.2, R14.2, U3.3, U4.P4 (BAT_SENS), U4.P12 (ISO_B1), U4.P13 (ISO_B2), U4.P14 (ISO_B3)
VBAT_ADC: JP20.4, R14.1, R15.2, U1.19 (ADC6)
VBAT_RTC: BAT1.PWR@1 (+), U3.14
VBUS: C6.A (+), JP13.2, R6.2, R18.2, U4.P6 (VIN1), U4.P7 (VIN2), U4.P8 (VIN3), X1.P1 (VBUS), X2.VBUS
VSYS: C14.A (+), R12.2, R24.1, R26.1, S3.3 (S), U4.P9 (ISO_S1), U4.P10 (ISO_S2), U4.P11 (ISO_S3)
VSYS_SW: C21.1, JP13.3, S3.2, U5.1 (IN), U5.3 (EN)
WALL: JP20.3, R18.1, R23.2, U1.22 (ADC7)
XTAL1: C3.1, U1.7 (PB6(XTAL1/TOSC1)), Y1.1
XTAL2: C4.1, U1.8 (PB7(XTAL2/TOSC2)), Y1.2
_NC1_USBA: X1.P2 (D-)
_NC2_USB_A: X1.P3 (D+)

Notes on the sheet:
VCC is 3.3V
Copyright (c) 2014 University of Washington Released under the Creative Commons Attribution 4.0 License http://creativecommons.org/licenses/by/4.0/
Phone charging plug (A)
fiducials
mount holes
Power, batteries charging, regulator, RTC
1-Wire Bus
Bluetooth
decoupling, mounting, fiducials
fit C17 optionally
foneastra charging plug (uB)
can be configured as SPI or ISP. Difference is whether reset or SS signal is routed to connector. Use jumper to select.
R21 and C19 form an RC filter to slow down the edge of the gate signal. The transistor otherwise switches very fast and the new load from the BT can cause an unacceptable voltage sag on V3.3 without it.
Regulator can be Micrel 5205 and tantalum C17 or Micrel 5245 and MLCC C17. You can't mix them the other way!

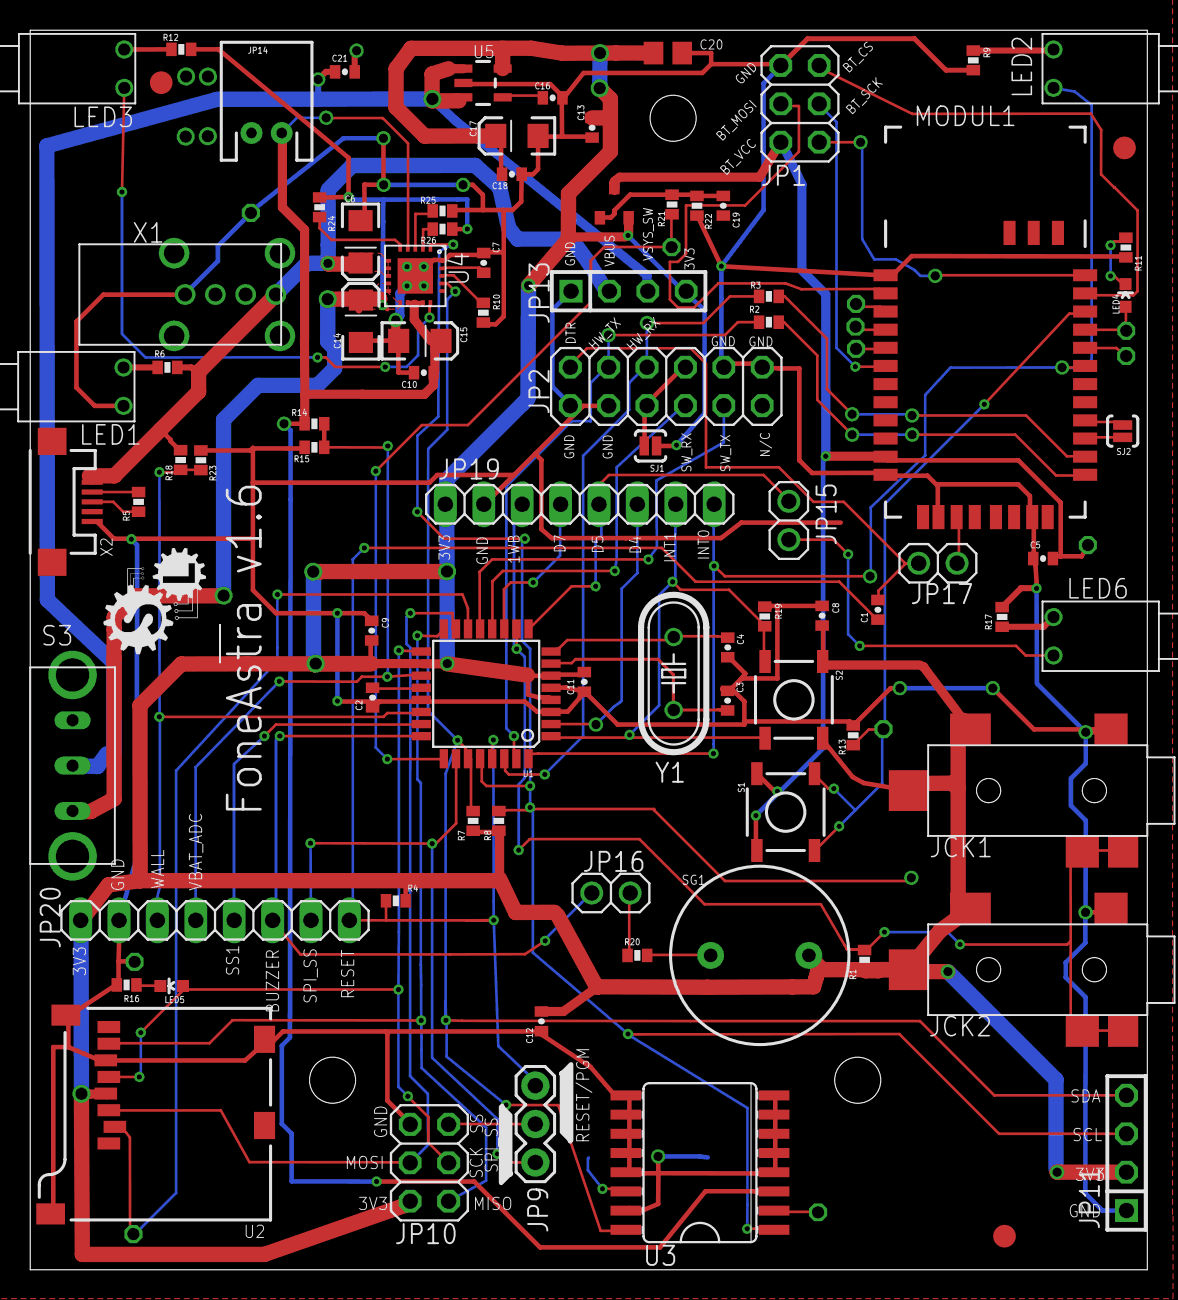
[picture p19: board FoneAstra.brd from above]

Board: 2 copper layers, 73.9 x 82.0 mm, 103 parts (1 on the bottom side), 72 nets.
