bkolko/foneastra/(commit log)

2015-03-05 Adding the PCB, test sketch, BOM, and programming instructions
    [FoneAstra.brd, FoneAstra.sch, FoneAstra_v1_6_BOM.xlsx]
2015-06-15 Added CAD files
    [48204-0001.SLDPRT, Body.STL, Body.sldprt, FoneAstra_PCB1-5.SLDASM, Foneastra_v2-3_Assembled.SLDASM, LED_3mm_591-2601-013F.sldprt, Lid.STL, Lid.sldprt]
2015-11-03 added hardware BOM
    [FoneAstra Hardware BOM.xlsx]
2016-03-08 Uploaded Gerbers
    Added gerber files for PCB
